kmu-kobot/2021ESWContest_4-_6013/(threads)

Thread 3 (2021-09-28):

pdf

bamin0422, 2021-09-28:
[2021ESWContest_4차산업기반에너지_6013_KOBOTBOART_개발완료보고서.pdf](https://github.com/kmu-kobot/2021ESWContest_4-_6013/files/7240984/2021ESWContest_4._6013_KOBOTBOART_.pdf)
